AnayMehta976/ViCAS/site/img/test-beam.webp

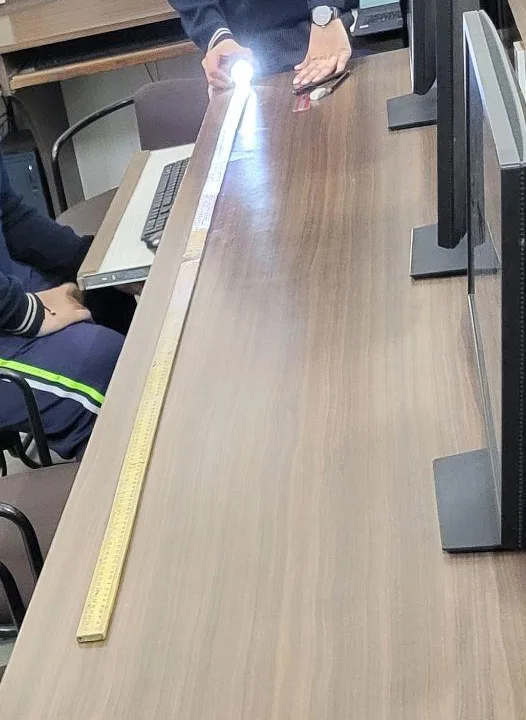
site/img/test-beam.webp
