AnayMehta976/ViCAS/site/img/test-speaker.webp

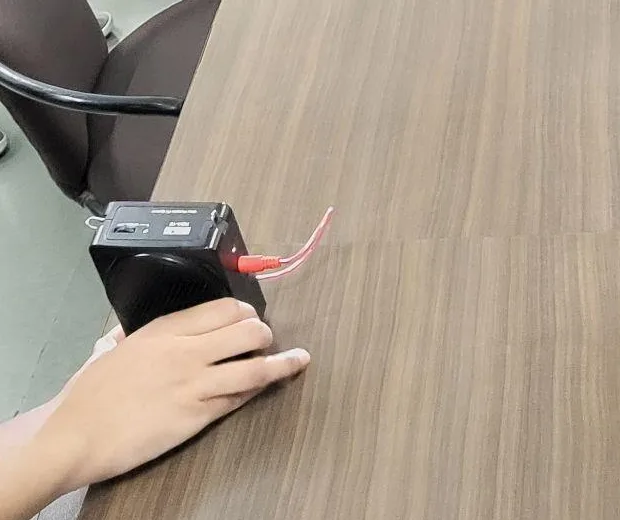
site/img/test-speaker.webp
