AnayMehta976/ViCAS/site/img/aictsl-centre.webp

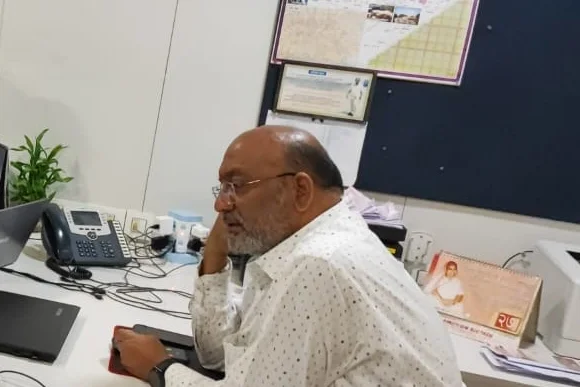
site/img/aictsl-centre.webp
