AnayMehta976/ViCAS/site/img/aictsl-desk.webp

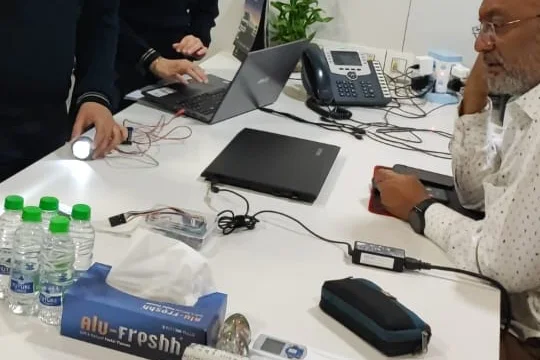
site/img/aictsl-desk.webp
