AnayMehta976/ViCAS/site/img/sketch-receiver.webp

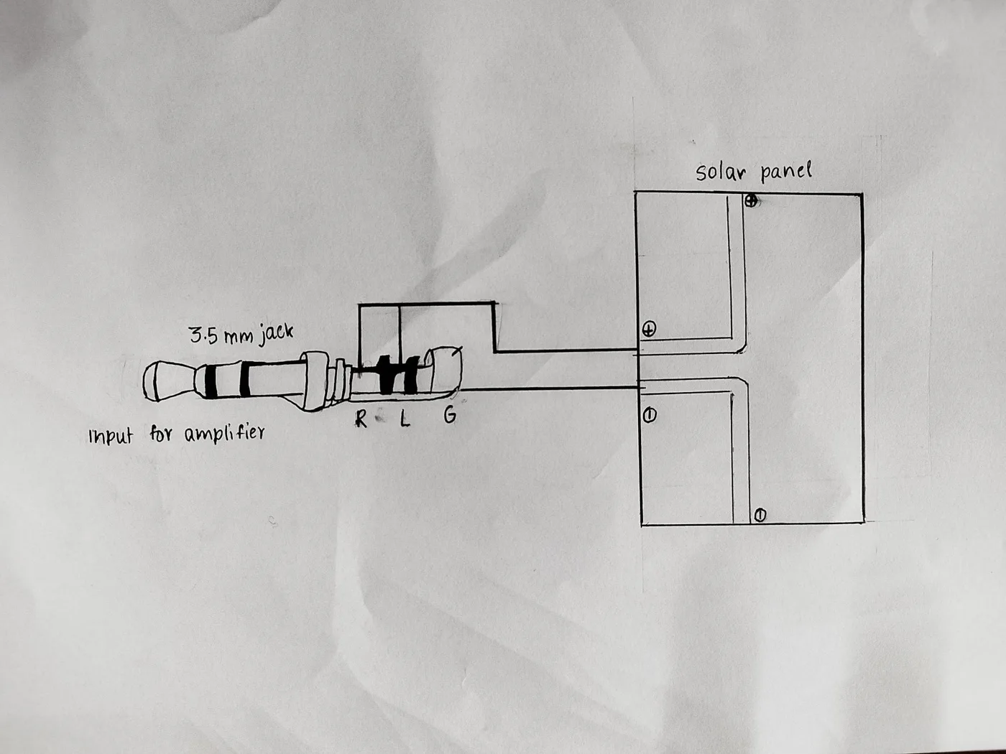
site/img/sketch-receiver.webp
