AnayMehta976/ViCAS/site/img/sketch-sender.webp

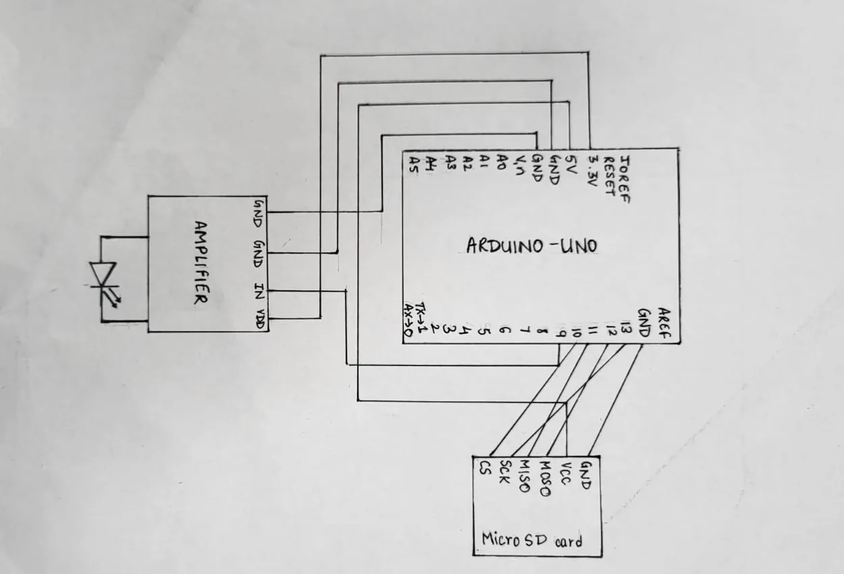
site/img/sketch-sender.webp
