AnayMehta976/ViCAS/(commit log)

2026-03-18 Add Receiver_LowLevel.ino - Timer1 interrupt-based stereo audio output
2026-03-18 Add comprehensive README with sender/receiver docs, pin configs, and contributors
    Updated README to enhance clarity and structure, added sections for overview, how it works, repository structure, sender and receiver details, hardware requirements, required libraries, WAV file setup, getting started instructions, contributors, and license information.
2026-10-26 Fix the sketches and rewrite the README
    - sender: move audio to pin 9 (TMRpcm/Timer1 on the Uno) and the keypad off it, consistent 1.WAV-9.WAV names, one volume setting, SD and missing-file checks
    - audio_test: replaces Receiver_Final, which only played test.wav and was not a light receiver
    - remove Receiver_LowLevel, which did not compile
    - each sketch in its own folder for the Arduino IDE
    - README rewritten from the project file, with wiring, setup and experiments
    [audio_test.ino, sender.ino]
2026-10-26 Add the ViCAS website
    Static site in site/: colour-chapter design, a live keypad that flashes each key's real Li-Fi frame and speaks the message, the build, the tests and the recognition. Self-hosted Libre Franklin and Source Serif 4 (SIL OFL).
2026-10-29 Rebuild the website: road-sign and truck-art design, new demos
    - Hero: the back of an Indian truck, HORN OK PLEASE becomes LIGHT, the LED beam reaches the panel
    - Horn board: four emergencies collapse into one HONK
    - Signal chain: one continuous signal that changes shape under each stage
    - Keypad demo: voice mode and digital Li-Fi frames, following the sketches
    - Why light: top-down road showing who receives each kind of wave
    - Test bench with conditions and distances, field visit, parts receipt, milestones
